paula78901/Incubadora-IoT-Sistema-seguro-de-monitoreo-y-control-ambiental-en-tiempo-real-/README.md

**Scripts y documentación utilizados a lo largo de este proyecto.**

Un proyecto elaborado por Rivaldo Hernández Magdaleno, Victoria Guevara y Paula Ivanna Hernández Rizo

**SCRIPITS PARA ARDUINO:**

ESP1_MAESTRO.ino - Correspondiente a la tarjeta ESP32-1: Comunicación UART con ESP32-2, lectura de sensores, comunicación mqtt

ESP2_Control_local.ino - Correspondiente a la tarjeta ESP32-2: Comunicación UART con ESP32-1, interfaz de control local con botones y pantalla LCD.

**SCRIPT PARA INTERFAZ REMOTA EN NODE-RED:**

flujo_completo_NODERED.json

**SIMULACIONES PROTEUS**

**DOCUMENTACIÓN**
