paula78901/Incubadora-IoT-Sistema-seguro-de-monitoreo-y-control-ambiental-en-tiempo-real-/(commit log)

2025-12-02 Add Arduino scripts section to README
2025-12-02 Update README with Arduino script details
    Added descriptions for Arduino scripts used in the project.
